Montso/EEE3088F_Micromouse/README.md

# EEE3080F Micromouse Project
This repo consists of the KiCAD files the sensing and power components of the micromouse project.
