Montso/EEE3088F_Micromouse/Power/README.md

Power board for the micromouse projecct under EEE3088F.
