Montso/EEE3088F_Micromouse/Power/additional libraries/DRV8837DSGR/DRV8837DSGR.step

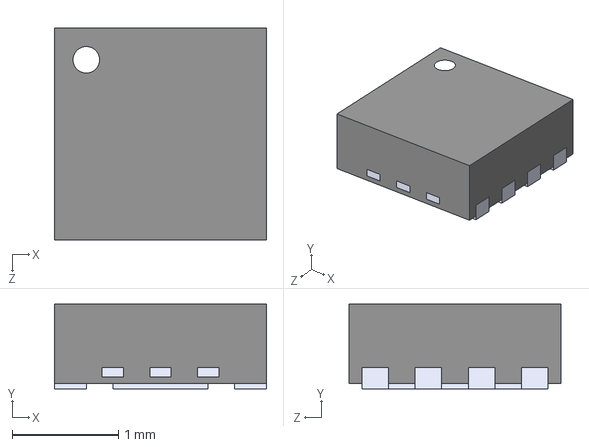
[picture p1: CAD file, 2024-03-23]
Power/additional libraries/DRV8837DSGR/DRV8837DSGR.step
2.00 x 0.8 x 2.00 mm
