Montso/EEE3088F_Micromouse/Power/additional libraries/L9110S/L9110S.step

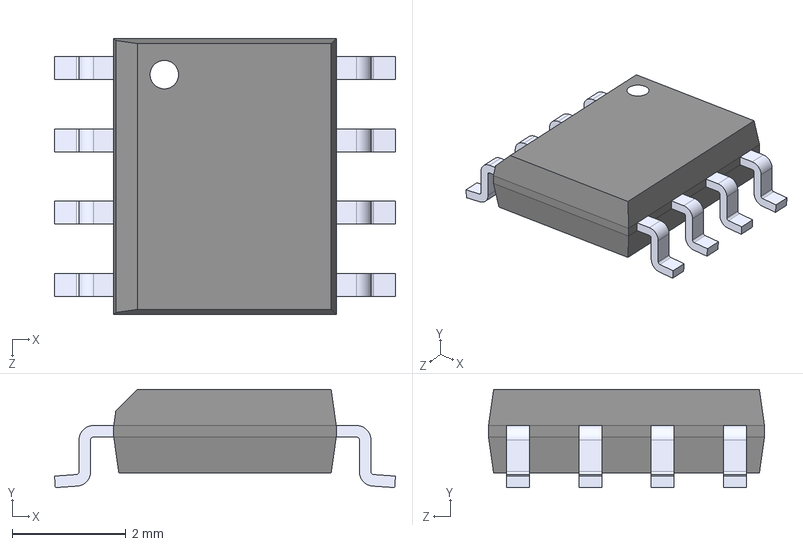
[picture p2: CAD file, 2024-03-14]
Power/additional libraries/L9110S/L9110S.step
5.99 x 1.73 x 4.85 mm
