Montso/EEE3088F_Micromouse/Power/additional libraries/TP4056/TP4056.step

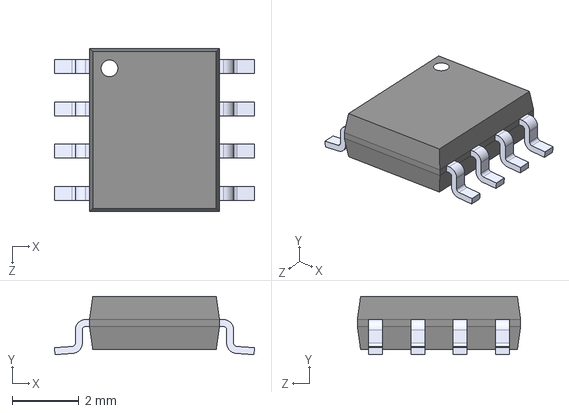
[picture p3: CAD file, 2024-03-14]
Power/additional libraries/TP4056/TP4056.step
6.00 x 1.75 x 4.90 mm
