Montso/EEE3088F_Micromouse/Power/Micromouse Power.kicad_pcb

## KiCad design Power/Micromouse Power.kicad_pcb (2024-04-08)

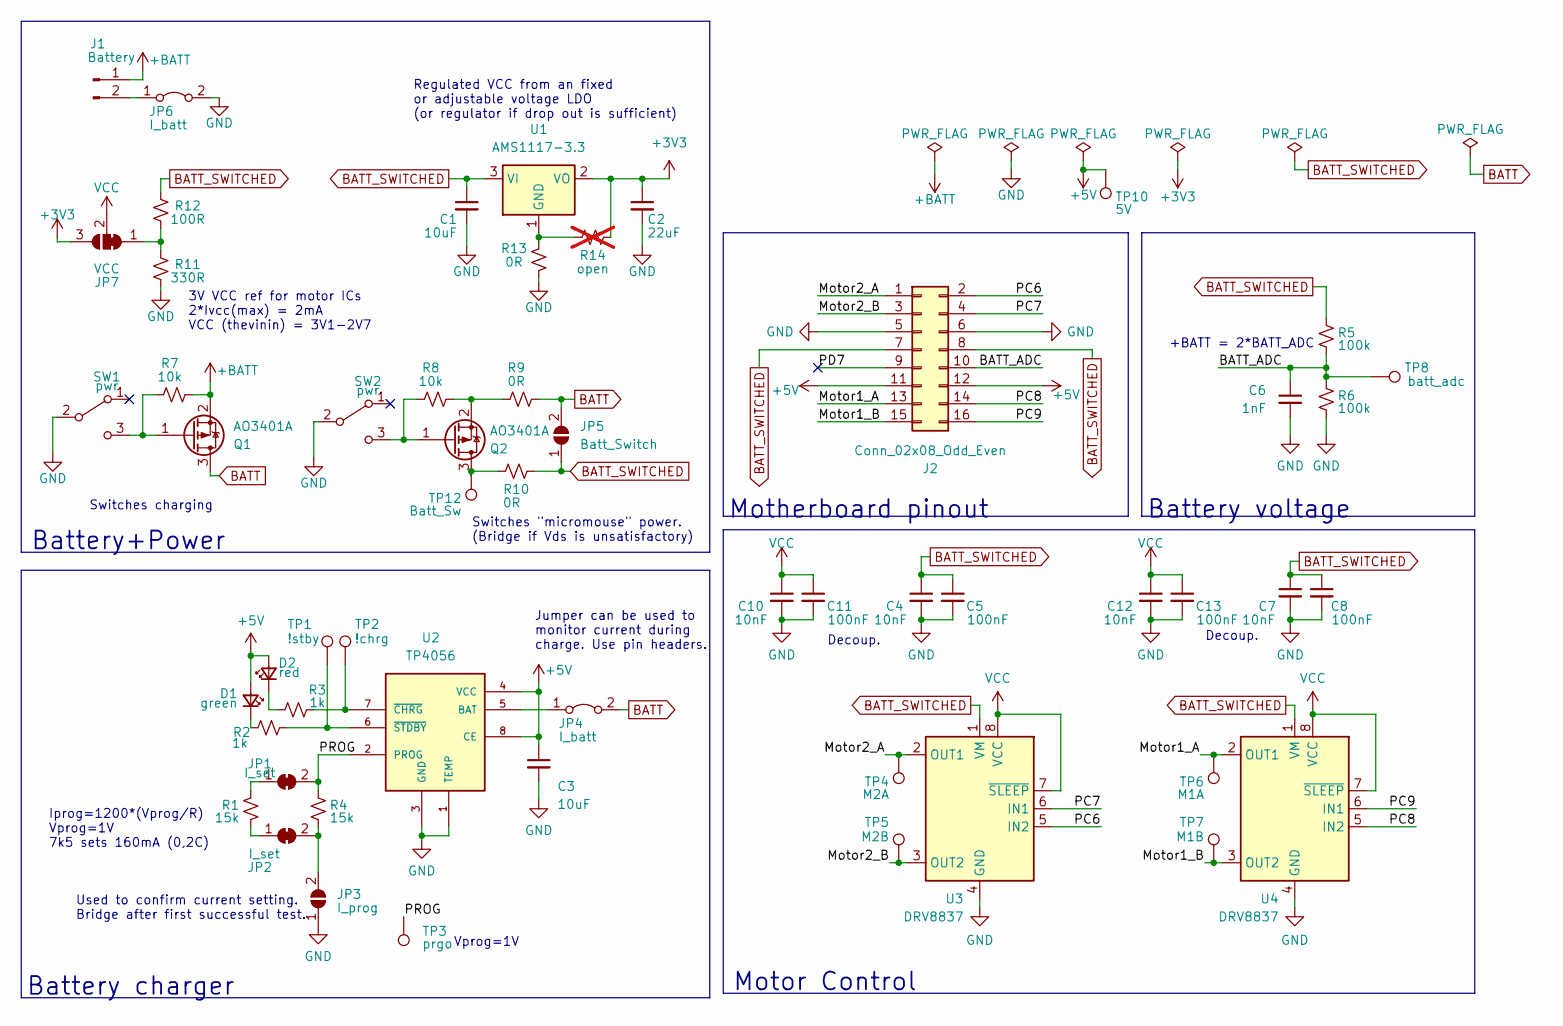
[picture p4: schematic Micromouse Power.kicad_sch]

Parts:
C1, C3: 10uF; C_0603_1608Metric; LCSC C19702
C2: 22uF; C_0603_1608Metric; LCSC C59461
C4, C7, C10, C12: 10nF; C_0603_1608Metric; LCSC C57112
C5, C8, C11, C13: 100nF; C_0603_1608Metric; LCSC C14663
C6: 1nF; C_0603_1608Metric; LCSC C1588
D1: green; LED_0603_1608Metric; LCSC C72038
D2: red; LED_0603_1608Metric; LCSC C2286
J1: Battery; JST_PH_S2B-PH-K_1x02_P2.00mm_Horizontal
J2: Conn_02x08_Odd_Even; PinHeader_2x08_P2.54mm_Vertical
JP1, JP2: I_set; SolderJumper-2_P1.3mm_Bridged_RoundedPad1.0x1.5mm
JP3: I_prog; SolderJumper-2_P1.3mm_Open_RoundedPad1.0x1.5mm
JP4, JP6: I_batt; PinHeader_1x02_P2.54mm_Vertical
JP5: Batt_Switch; SolderJumper-2_P1.3mm_Open_RoundedPad1.0x1.5mm
JP7: VCC; SolderJumper-3_P1.3mm_Bridged12_Pad1.0x1.5mm_NumberLabels
Q1, Q2: AO3401A; SOT-23; LCSC C15127
R1, R4: 15k; R_0805_2012Metric_Pad1.20x1.40mm_HandSolder; LCSC C17475
R2, R3: 1k; R_0603_1608Metric_Pad0.98x0.95mm_HandSolder; LCSC C21190
R5, R6: 100k; R_0603_1608Metric_Pad0.98x0.95mm_HandSolder; LCSC C25803
R7, R8: 10k; R_0603_1608Metric_Pad0.98x0.95mm_HandSolder; LCSC C25804
R9, R10, R13: 0R; R_0603_1608Metric_Pad0.98x0.95mm_HandSolder; LCSC C21189
R11: 330R; R_0603_1608Metric_Pad0.98x0.95mm_HandSolder; LCSC C23138
R12: 100R; R_0603_1608Metric_Pad0.98x0.95mm_HandSolder; LCSC C22775
R14: open; R_0603_1608Metric_Pad0.98x0.95mm_HandSolder; not fitted
SW1, SW2: pwr; SMD_SPDT; LCSC C145857
TP1: !stby; TestPoint_Pad_D1.0mm
TP2: !chrg; TestPoint_Pad_D1.0mm
TP3: prgo; TestPoint_Pad_D1.0mm
TP4: M2A; TestPoint_Pad_D1.0mm
TP5: M2B; TestPoint_Pad_D1.0mm
TP6: M1A; TestPoint_Pad_D1.0mm
TP7: M1B; TestPoint_Pad_D1.0mm
TP8: batt_adc; TestPoint_Pad_D1.0mm
TP10: 5V; TestPoint_Pad_D1.0mm
TP12: Batt_Sw; TestPoint_Pad_D1.0mm
U1: AMS1117-3.3; SOT-223-3_TabPin2; LCSC C6186
U2: TP4056; SOP127P600X175-9N; LCSC C16581
U3, U4: DRV8837; WSON-8-1EP_2x2mm_P0.5mm_EP0.9x1.6mm; LCSC C191000

Connections:
+3V3: C2.1, JP7.3 (B), R14.1, U1.2 (VO)
+5V: C3.1, D1.2 (A), D2.2 (A), J2.11, J2.12, TP10.1, U2.4 (VCC), U2.8 (CE)
+BATT: J1.1, Q1.2 (S), R7.1
/BATT_ADC: C6.1, J2.10, R5.1, R6.2, TP8.1
/Motor1_A: J2.13, TP6.1, U4.2 (OUT1)
/Motor1_B: J2.15, TP7.1, U4.3 (OUT2)
/Motor2_A: J2.1, TP4.1, U3.2 (OUT1)
/Motor2_B: J2.3, TP5.1, U3.3 (OUT2)
/PC6: J2.2, U3.5 (IN2)
/PC7: J2.4, U3.6 (IN1)
/PC8: J2.14, U4.5 (IN2)
/PC9: J2.16, U4.6 (IN1)
/PD7: J2.9
/PROG: JP1.2 (B), R4.2, TP3.1, U2.2 (PROG)
BATT: JP4.2 (B), JP5.2 (B), Q1.3 (D), R9.1
BATT_SWITCHED: C1.1, C4.1, C5.1, C7.1, C8.1, J2.7, J2.8, JP5.1 (A), R5.2, R10.2, R12.1, U1.3 (VI), U3.1 (VM), U4.1 (VM)
GND: C1.2, C2.2, C3.2, C4.2, C5.2, C6.2, C7.2, C8.2, C10.2, C11.2, C12.2, C13.2, J2.5, J2.6, JP3.1 (A), JP6.2 (B), R6.1, R11.2, R13.1, SW1.2 (B), SW2.2 (B), U2.1 (TEMP), U2.3 (GND), U3.4 (GND), U3.9 (GND), U4.4 (GND), U4.9 (GND)
unnamed: D1.1 (K), R2.1
unnamed: D2.1 (K), R3.1
unnamed: J1.2, JP6.1 (A)
unnamed: JP1.1 (A), R1.2
unnamed: JP2.1 (A), R1.1
unnamed: JP2.2 (B), JP3.2 (B), R4.1
unnamed: JP4.1 (A), U2.5 (BAT)
unnamed: JP7.1 (A), R11.1, R12.2
unnamed: Q1.1 (G), R7.2, SW1.3 (C)
unnamed: Q2.3 (D), R10.1, TP12.1
unnamed: Q2.1 (G), R8.2, SW2.3 (C)
unnamed: Q2.2 (S), R8.1, R9.2
unnamed: R13.2, R14.2, U1.1 (GND)
unnamed: R3.2, TP2.1, U2.7 (~CHRG)
unnamed: R2.2, TP1.1, U2.6 (~STDBY)
VCC: C10.1, C11.1, C12.1, C13.1, JP7.2 (C), U3.7 (~SLEEP), U3.8 (VCC), U4.7 (~SLEEP), U4.8 (VCC)

Notes on the sheet:
Battery+Power
Regulated VCC from an fixed or adjustable voltage LDO (or regulator if drop out is sufficient)
Vprog=1V
Motherboard pinout
+BATT = 2*BATT_ADC
Decoup.
Used to confirm current setting. Bridge after first successful test.
Motor Control
Switches "micromouse" power. (Bridge if Vds is unsatisfactory)
3V VCC ref for motor ICs 2*Ivcc(max) = 2mA VCC (thevinin) = 3V1-2V7
Switches charging
Battery voltage
Battery charger
Iprog=1200*(Vprog/R) Vprog=1V 7k5 sets 160mA (0,2C)
Jumper can be used to monitor current during charge. Use pin headers.

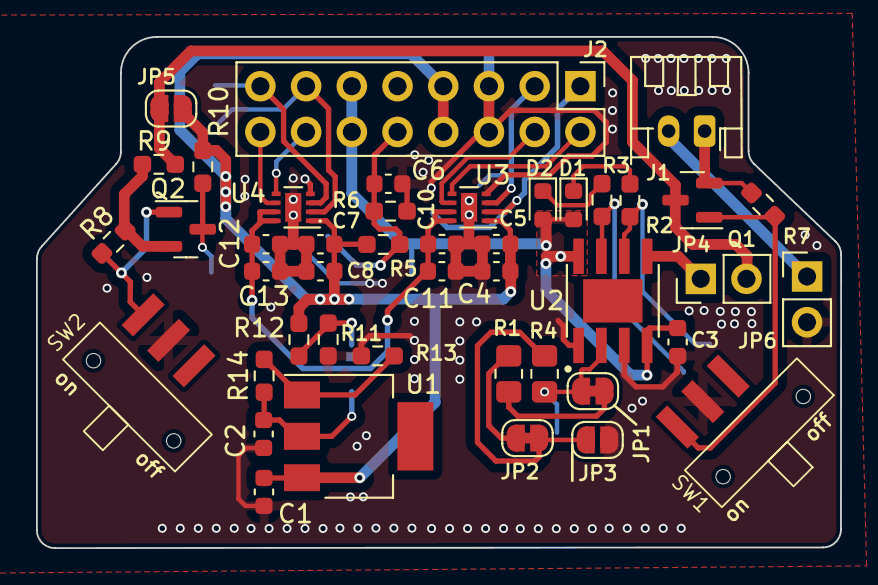
[picture p5: board Micromouse Power.kicad_pcb from above]

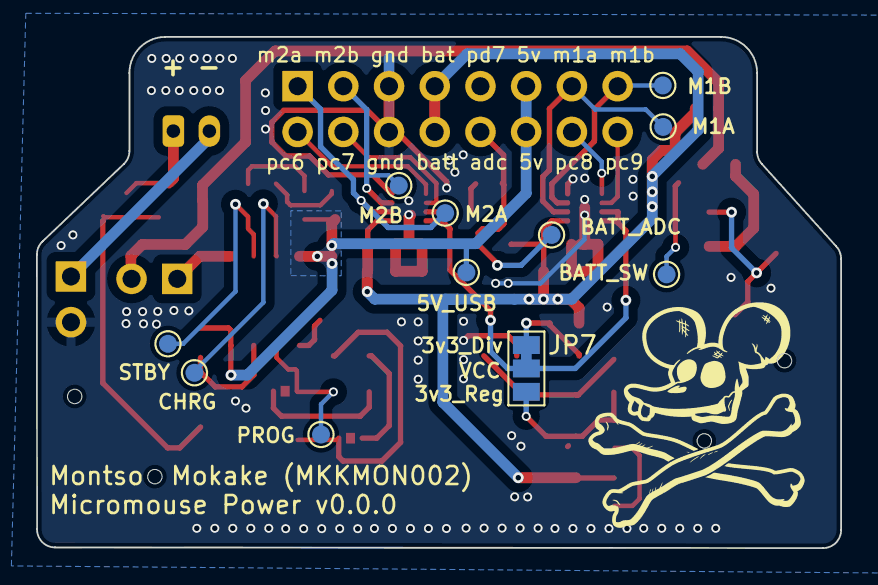
[picture p6: board Micromouse Power.kicad_pcb from below]

Board: 2 copper layers, 44.7 x 28.4 mm, 55 parts (11 on the bottom side), 32 nets.
