Montso/EEE3088F_Micromouse/Sensor/EEE3088F Micromouse.kicad_pcb

## KiCad design Sensor/EEE3088F Micromouse.kicad_pcb (2024-04-05)

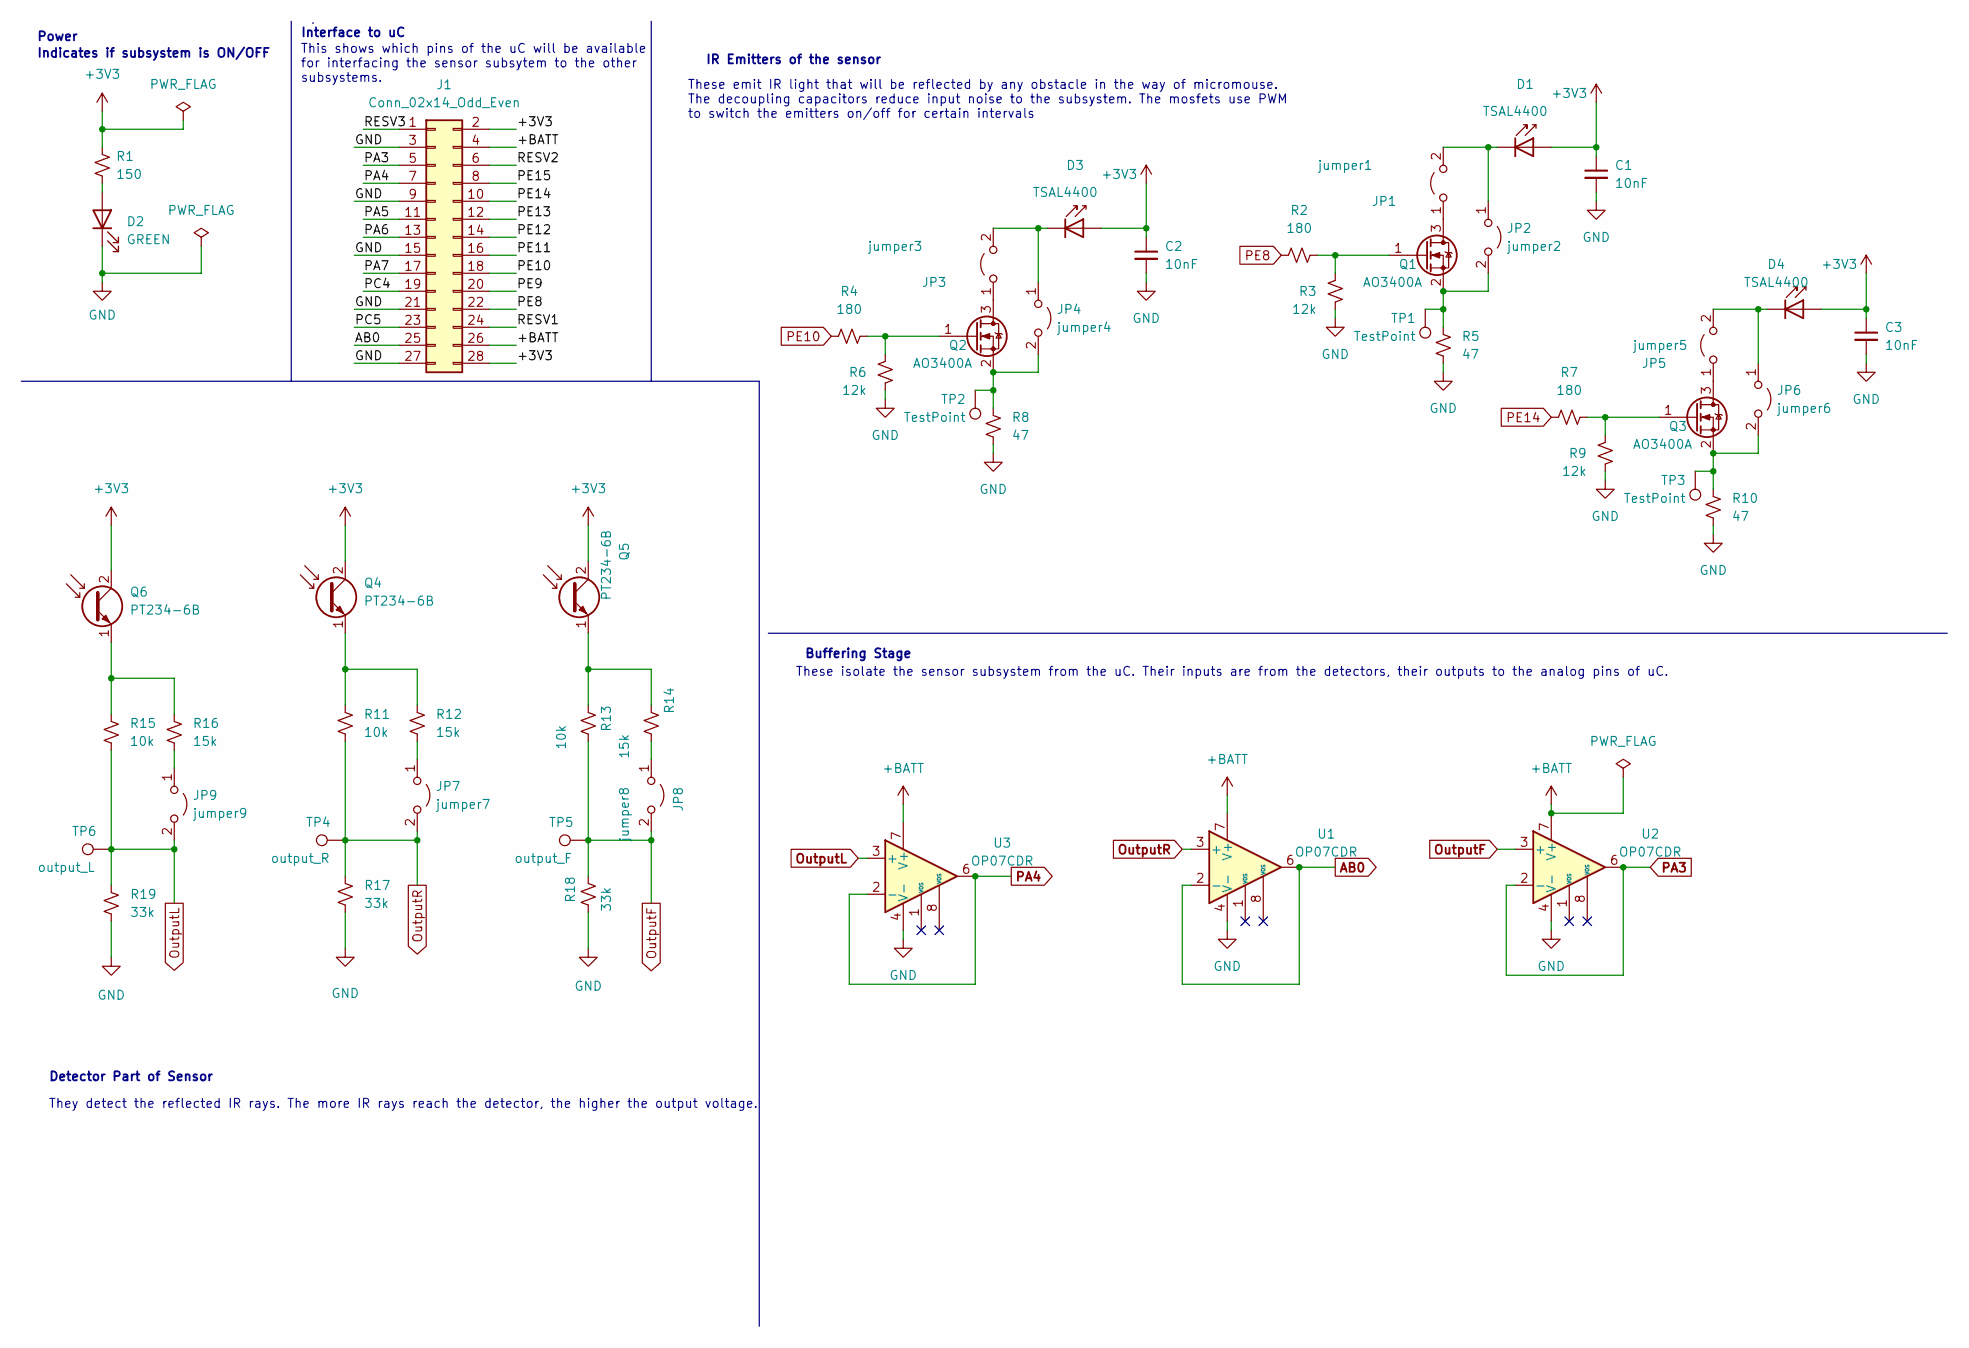
[picture p7: schematic EEE3088F Micromouse.kicad_sch, Micromouse Schematic]

Parts:
C1, C2, C3: 10nF; C_0805_2012Metric
D1, D3, D4: TSAL4400; LED_D3.0mm_Horizontal_O1.27mm_Z2.0mm
D2: GREEN; LED_0805_2012Metric
J1: Conn_02x14_Odd_Even; PinHeader_2x14_P2.54mm_Vertical
JP1: jumper1; SolderJumper-2_P1.3mm_Open_Pad1.0x1.5mm
JP2: jumper2; SolderJumper-2_P1.3mm_Open_Pad1.0x1.5mm
JP3: jumper3; SolderJumper-2_P1.3mm_Open_Pad1.0x1.5mm
JP4: jumper4; SolderJumper-2_P1.3mm_Open_Pad1.0x1.5mm
JP5: jumper5; SolderJumper-2_P1.3mm_Open_Pad1.0x1.5mm
JP6: jumper6; SolderJumper-2_P1.3mm_Open_Pad1.0x1.5mm
JP7: jumper7; SolderJumper-2_P1.3mm_Open_Pad1.0x1.5mm
JP8: jumper8; SolderJumper-2_P1.3mm_Open_Pad1.0x1.5mm
JP9: jumper9; SolderJumper-2_P1.3mm_Open_Pad1.0x1.5mm
Q1, Q2, Q3: AO3400A; SOT-23
Q4, Q5, Q6: PT234-6B
R1: 150; R_0805_2012Metric
R2, R4, R7: 180; R_0805_2012Metric
R3, R6, R9: 12k; R_0805_2012Metric
R5, R8, R10: 47; R_0805_2012Metric
R11, R13, R15: 10k; R_0805_2012Metric
R12, R14, R16: 15k; R_0805_2012Metric
R17, R18, R19: 33k; R_0805_2012Metric
TP1, TP2, TP3: TestPoint; TestPoint_Pad_D3.0mm
TP4: output_R; TestPoint_Pad_D3.0mm
TP5: output_F; TestPoint_Pad_D3.0mm
TP6: output_L; TestPoint_Pad_D3.0mm
U1, U2, U3: OP07CDR; SOIC127P599X175-8N

Connections:
+3V3: C1.1, C2.1, C3.1, D1.2 (A), D3.2 (A), D4.2 (A), J1.2, J1.28, Q4.2 (C), Q5.2 (C), Q6.2 (C), R1.1
+BATT: J1.4, J1.26, U1.7 (V+), U2.7 (V+), U3.7 (V+)
/PA5: J1.11
/PA6: J1.13
/PA7: J1.17
/PC4: J1.19
/PC5: J1.23
/PE9: J1.20
/PE11: J1.16
/PE12: J1.14
/PE13: J1.12
/PE15: J1.8
/RESV1: J1.24
/RESV2: J1.6
/RESV3: J1.1
AB0: J1.25, U1.2 (-), U1.6
GND: C1.2, C2.2, C3.2, D2.1 (K), J1.3, J1.9, J1.15, J1.21, J1.27, R3.2, R5.2, R6.2, R8.2, R9.2, R10.2, R17.2, R18.2, R19.2, U1.4 (V-), U2.4 (V-), U3.4 (V-)
unnamed: D1.1 (K), JP1.2 (B), JP2.1 (A)
unnamed: D2.2 (A), R1.2
unnamed: D3.1 (K), JP3.2 (B), JP4.1 (A)
unnamed: D4.1 (K), JP5.2 (B), JP6.1 (A)
unnamed: JP1.1 (A), Q1.3 (D)
unnamed: JP2.2 (B), Q1.2 (S), R5.1, TP1.1
unnamed: JP3.1 (A), Q2.3 (D)
unnamed: JP4.2 (B), Q2.2 (S), R8.1, TP2.1
unnamed: JP5.1 (A), Q3.3 (D)
unnamed: JP6.2 (B), Q3.2 (S), R10.1, TP3.1
unnamed: JP7.1 (A), R12.2
unnamed: JP8.1 (A), R14.2
unnamed: JP9.1 (A), R16.2
unnamed: Q1.1 (G), R2.2, R3.1
unnamed: Q2.1 (G), R4.2, R6.1
unnamed: Q3.1 (G), R7.2, R9.1
unnamed: Q4.1 (E), R11.1, R12.1
unnamed: Q5.1 (E), R13.1, R14.1
unnamed: Q6.1 (E), R15.1, R16.1
OutputF: JP8.2 (B), R13.2, R18.1, TP5.1, U2.3 (+)
OutputL: JP9.2 (B), R15.2, R19.1, TP6.1, U3.3 (+)
OutputR: JP7.2 (B), R11.2, R17.1, TP4.1, U1.3 (+)
PA3: J1.5, U2.2 (-), U2.6
PA4: J1.7, U3.2 (-), U3.6
PE8: J1.22, R2.1
PE10: J1.18, R4.1
PE14: J1.10, R7.1

Notes on the sheet:
IR Emitters of the sensor
These emit IR light that will be reflected by any obstacle in the way of micromouse. The decoupling capacitors reduce input noise to the subsystem. The mosfets use PWM to switch the emitters on/off for certain intervals
This shows which pins of the uC will be available for interfacing the sensor subsytem to the other subsystems.
They detect the reflected IR rays. The more IR rays reach the detector, the higher the output voltage.
Interface to uC
Indicates if subsystem is ON/OFF
Detector Part of Sensor
These isolate the sensor subsystem from the uC. Their inputs are from the detectors, their outputs to the analog pins of uC.
Buffering Stage
Power

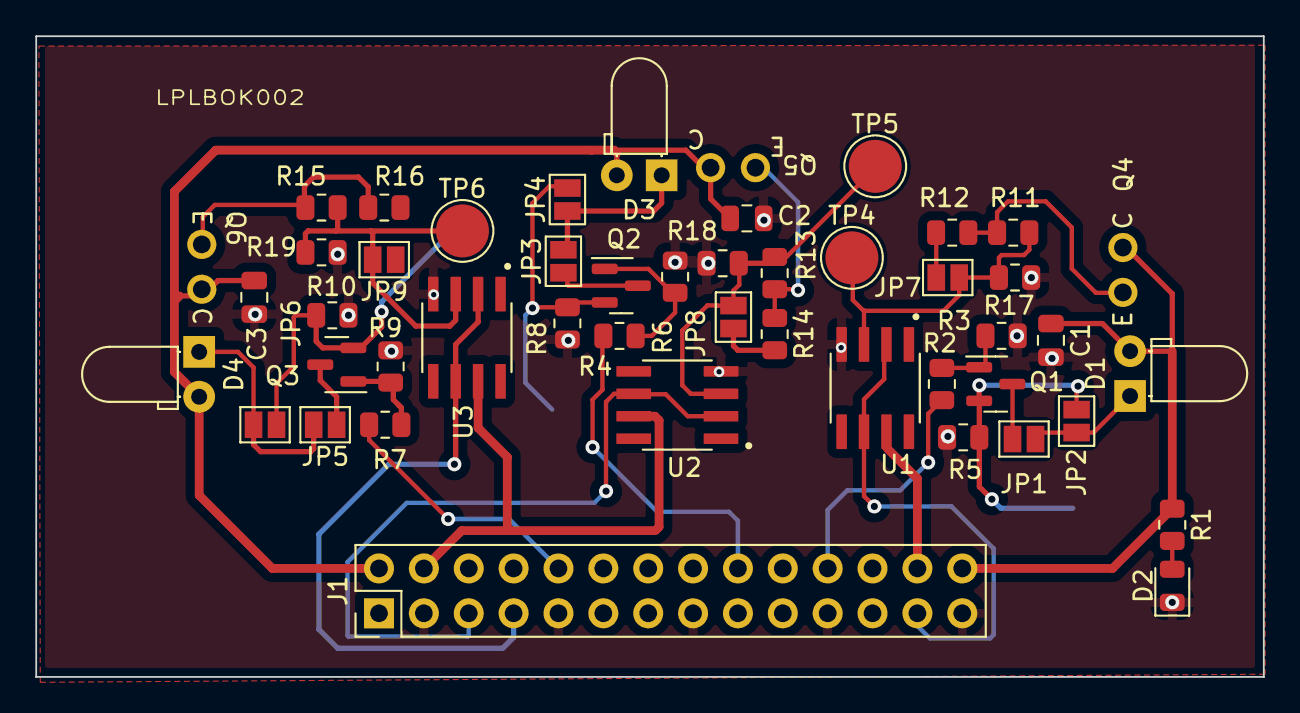
[picture p8: board EEE3088F Micromouse.kicad_pcb from above]

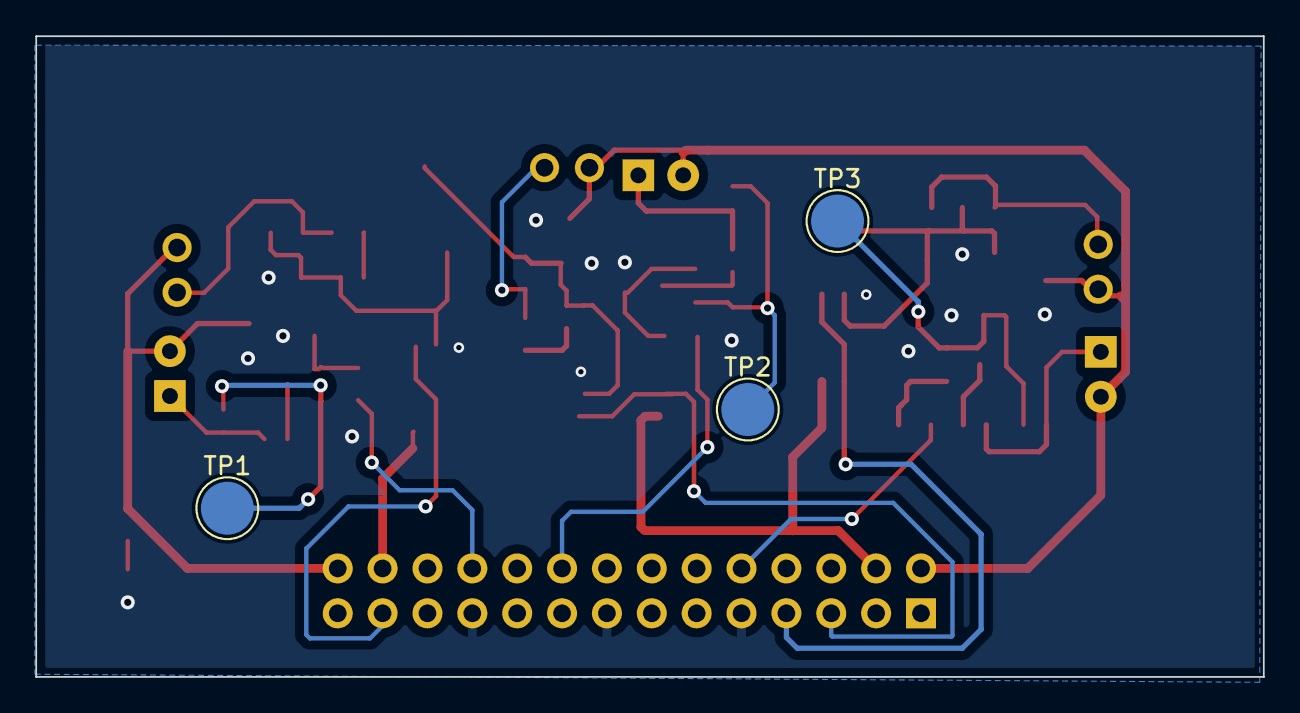
[picture p9: board EEE3088F Micromouse.kicad_pcb from below]

Board: 2 copper layers, 69.5 x 36.3 mm, 51 parts (3 on the bottom side), 31 nets.
