Montso/EEE3088F_Micromouse/(commit log)

2024-03-14 Added additional libraries
    [L9110S.step, TP4056.step]
2024-03-14 Created power sub-dir
    [L9110S.step, Micromouse Power.kicad_pcb, Micromouse Power.kicad_sch, TP4056.step]
2024-03-14 Created Sensor sub-dir
    [Micromouse Sensing.kicad_pcb, Micromouse Sensing.kicad_sch]
2024-03-14 Created motor, charger, and sens schematics
    [Micromouse Power.kicad_sch]
2024-03-15 Added power flags
    [Micromouse Power.kicad_sch]
2024-03-15 Added test points and i_prog jumper.
    [Micromouse Power.kicad_sch]
2024-03-16 Added more test points and jumpers.
    [Micromouse Power.kicad_sch]
2024-03-16 Updated GPIO PC6-9 label on 08 connector
    [Micromouse Power.kicad_sch]
2024-03-16 Assigned some footprints
    [Micromouse Power.kicad_sch]
2024-03-17 Added IC lcsc numbers
    [Micromouse Power.kicad_pcb, Micromouse Power.kicad_sch]
2024-03-17 Added switched +batt
    [Micromouse Power.kicad_sch]
2024-03-18 Added drv8837 libraries
    [DRV8837DSGR.step]
2024-03-18 Changed motor IC to drv8837
    [Micromouse Power.kicad_sch]
2024-03-18 Added 3v3 LDO
    [Micromouse Power.kicad_sch]
2024-03-18 Assigned footprints. Except switch
    [Micromouse Power.kicad_sch]
2024-03-18 Populated pcb
    [Micromouse Power.kicad_pcb]
2024-03-18 Updated document details
    [Micromouse Power.kicad_pcb, Micromouse Power.kicad_sch]
2024-03-19 Imported pcb design rules
    [Micromouse Power.kicad_pcb]
2024-03-19 Added Hor. battery connector. Temp switch ft.
    [Micromouse Power.kicad_sch]
2024-03-19 Added 3v3 decoup for drv8837
    [Micromouse Power.kicad_sch]
2024-03-20 PCB routing optimisation
    [Micromouse Power.kicad_sch]
2024-03-20 Initial board layout done
    [Micromouse Power.kicad_pcb]
2024-03-20 Added pmos+switch circuit
    [Micromouse Power.kicad_sch]
2024-03-20 Added switch circuit
    [Micromouse Power.kicad_pcb]
2024-03-21 Assigned footprints, hor. jst and switches
    [Micromouse Power.kicad_sch]
2024-03-21 Removed power decoup
    [Micromouse Power.kicad_sch]
2024-03-21 Routing and removes power decoup
    [Micromouse Power.kicad_pcb]
2024-03-21 Updated routing
    [Micromouse Power.kicad_pcb]
2024-03-21 Updated schematic
    [Micromouse Power.kicad_sch]
2024-03-22 Updated document titles
    [Micromouse Power.kicad_pcb, Micromouse Power.kicad_sch]
2024-03-22 Fixed charge-power switching
    [Micromouse Power.kicad_sch]
2024-03-22 Added switch silkscreen
    [Micromouse Power.kicad_pcb]
2024-03-22 Fixed M2 testpoints
    [Micromouse Power.kicad_sch]
2024-03-22 Review and touchups
    -added silkscreen art and info
    -fixed tp4056 decoupling
    [Micromouse Power.kicad_pcb]
2024-03-22 Final review and title info
    [Micromouse Power.kicad_sch]
2024-03-23 Added datasheets and jlcpcb files
    [Micromouse Power-CuBottom.gbr, Micromouse Power-CuTop.gbr, Micromouse Power-EdgeCuts.gbr, Micromouse Power-MaskBottom.gbr, Micromouse Power-MaskTop.gbr, Micromouse Power-NPTH.drl, Micromouse Power-PTH.drl, Micromouse Power-PasteBottom.gbr]
2024-03-23 Added voltage divider for VCC
    [Micromouse Power.kicad_sch]
2024-03-23 Added VCC divider for driver.
    -Jumper to select VCC
    -Stitching vias
    -Silkscreen
    [Micromouse Power.kicad_pcb]
2024-03-23 Fixed tab width
    [Micromouse Power.kicad_pcb]
2024-03-23 Added jlcpcb files
    [BOM-Micromouse Power.csv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]
2024-04-05 Delete Sensor/Micromouse Sensing.kicad_pcb
    Not appropriate version for me
    [Micromouse Sensing.kicad_pcb]
2024-04-05 Delete Sensor/Micromouse Sensing.kicad_pro
    version problem
2024-04-05 Delete Sensor/Micromouse Sensing.kicad_sch
    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
    [Micromouse Sensing.kicad_sch]
2024-04-05 Add files via upload
    PROJECT FILES AS AT 24/03/2024
    [EEE3088F Micromouse.kicad_pcb, EEE3088F Micromouse.kicad_sch]
2024-04-05 Delete Sensor/datasheets/1811101704_Vishay-Intertech-TSAL6100_C111836.pdf
    Part not on JLCPCB
2024-04-05 Delete Sensor/datasheets/asset_pdf_5174731.pdf
    Replace with phototransistor.
2024-04-05 Delete Sensor/datasheets/2206171645_OSRAM-Opto-Semicon-SFH-2400-FA-Z_C2900223.pdf
    Prefer through-holes for this part.
2024-04-05 Delete Sensor/datasheets/1809042023_ST-Semtech-2N3904_C118538.pdf
    Replace with op-amp.
2024-04-05 Add files via upload
    Mosfet for switching the IR-emitter on/off
2024-04-05 Delete Sensor/EEE3088F Micromouse.kicad_pcb
    Older schematic
    [EEE3088F Micromouse.kicad_pcb]
2024-04-05 Delete Sensor/EEE3088F Micromouse.kicad_pro
    Older project file
2024-04-05 Delete Sensor/EEE3088F Micromouse.kicad_sch
    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
    [EEE3088F Micromouse.kicad_sch]
2024-04-05 Add files via upload
    Updated kicad project files
    [EEE3088F Micromouse.kicad_pcb, EEE3088F Micromouse.kicad_sch]
2024-04-05 Add files via upload
    Additional footprints used.
2024-04-05 Add files via upload
    STM32L476 files
2024-04-05 Added student card to silkscreen
    [Micromouse Power.kicad_pcb]
2024-04-07 Added comments for battery schematics
    [Micromouse Power.kicad_sch]
2024-04-07 Updated jlcpcb files
    [Micromouse Power-CuBottom.gbr, Micromouse Power-CuTop.gbr, Micromouse Power-EdgeCuts.gbr, Micromouse Power-MaskBottom.gbr, Micromouse Power-MaskTop.gbr, Micromouse Power-NPTH.drl, Micromouse Power-PTH.drl, Micromouse Power-PasteBottom.gbr]
2024-04-08 Fixed conflict schematic
    [Micromouse Power.kicad_sch]
2024-04-08 Fixed pcb file
    [Micromouse Power.kicad_pcb]
2024-04-09 Updated schematic notes
    [Micromouse Power.kicad_sch]
2024-04-18 Updated text on schematic
    [Micromouse Power.kicad_sch]
